kenyoshizoe/brio/brio_description/meshes/brio_l4.stl

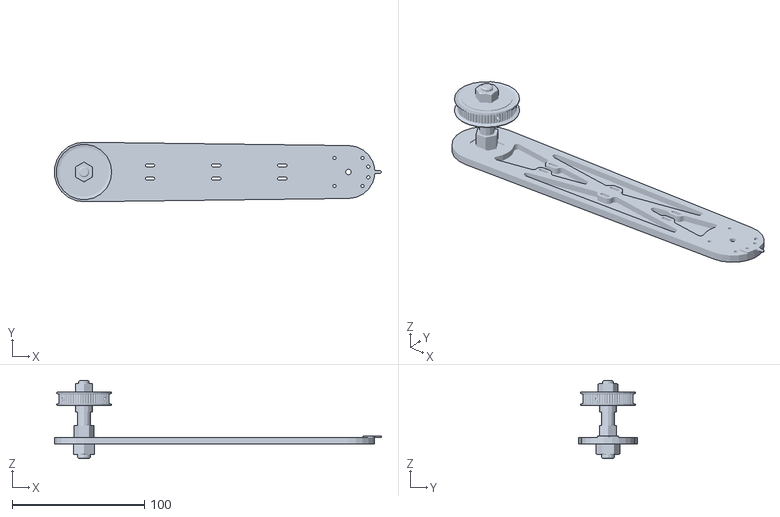
[picture p1: CAD file, 2023-04-27]
brio_description/meshes/brio_l4.stl
247.2 x 45.0 x 59.0
