kenyoshizoe/brio/brio_description/meshes/brio_l3.stl

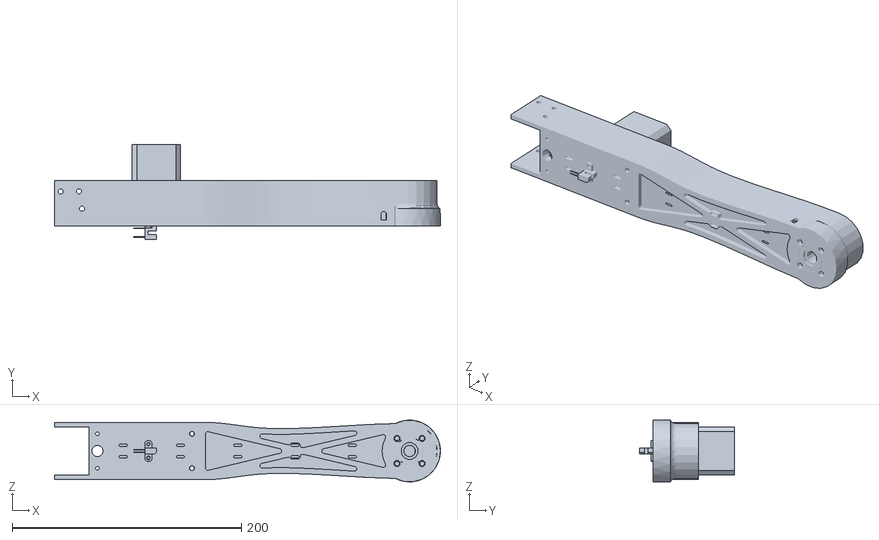
[picture p2: CAD file, 2023-04-27]
brio_description/meshes/brio_l3.stl
337.0 x 83.0 x 54.0
