kenyoshizoe/brio/brio_description/meshes/brio_l1.stl

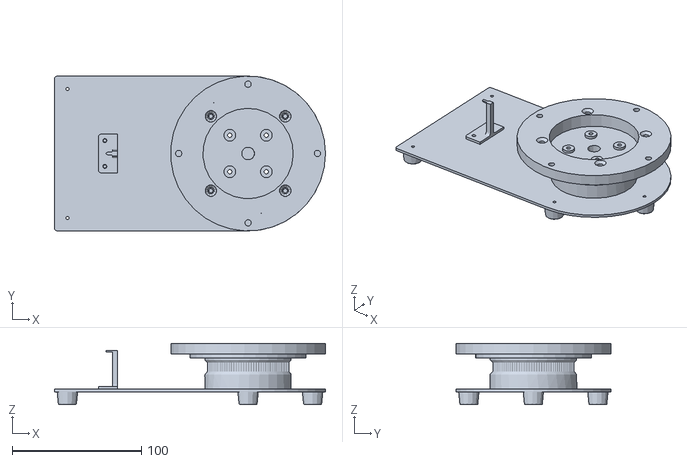
[picture p3: CAD file, 2023-04-27]
brio_description/meshes/brio_l1.stl
210.0 x 120.0 x 47.6
