kenyoshizoe/brio/brio_description/meshes/brio_l2.stl

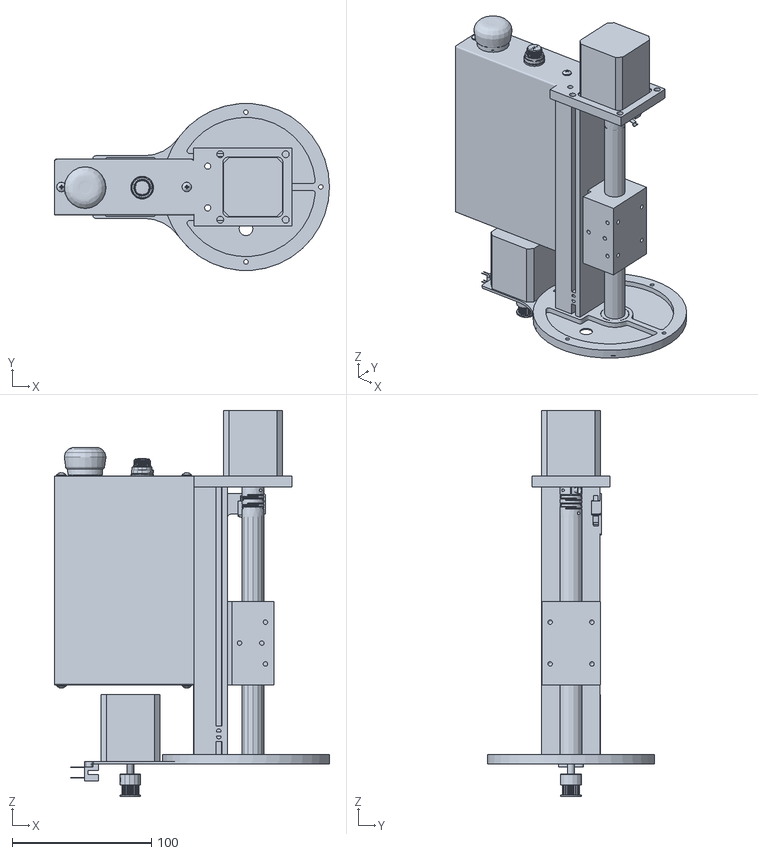
[picture p4: CAD file, 2023-04-27]
brio_description/meshes/brio_l2.stl
197.5 x 119.8 x 277.2
