kenyoshizoe/brio/(threads)

Thread 18 (2023-06-08):

手動操作用ノード作る

kenyoshizoe, 2023-06-08:
目標位置をコントローラで移動させてなんかのボタン押すと目標司令を送る、みたいな
目標位置はmarker出してrviz上で確認できるようにする

kenyoshizoe, 2023-06-08:
joystickの状態取得プログラム書くの面倒なので一旦
https://github.com/ros-drivers/joystick_drivers
でsensor_msgs/joy出してもらってそれを読んでどうこうする感じがいいかな
