kenyoshizoe/brio/pcb/main_board/main_board.kicad_pcb

## KiCad design pcb/main_board/main_board.kicad_pcb (2023-04-16)

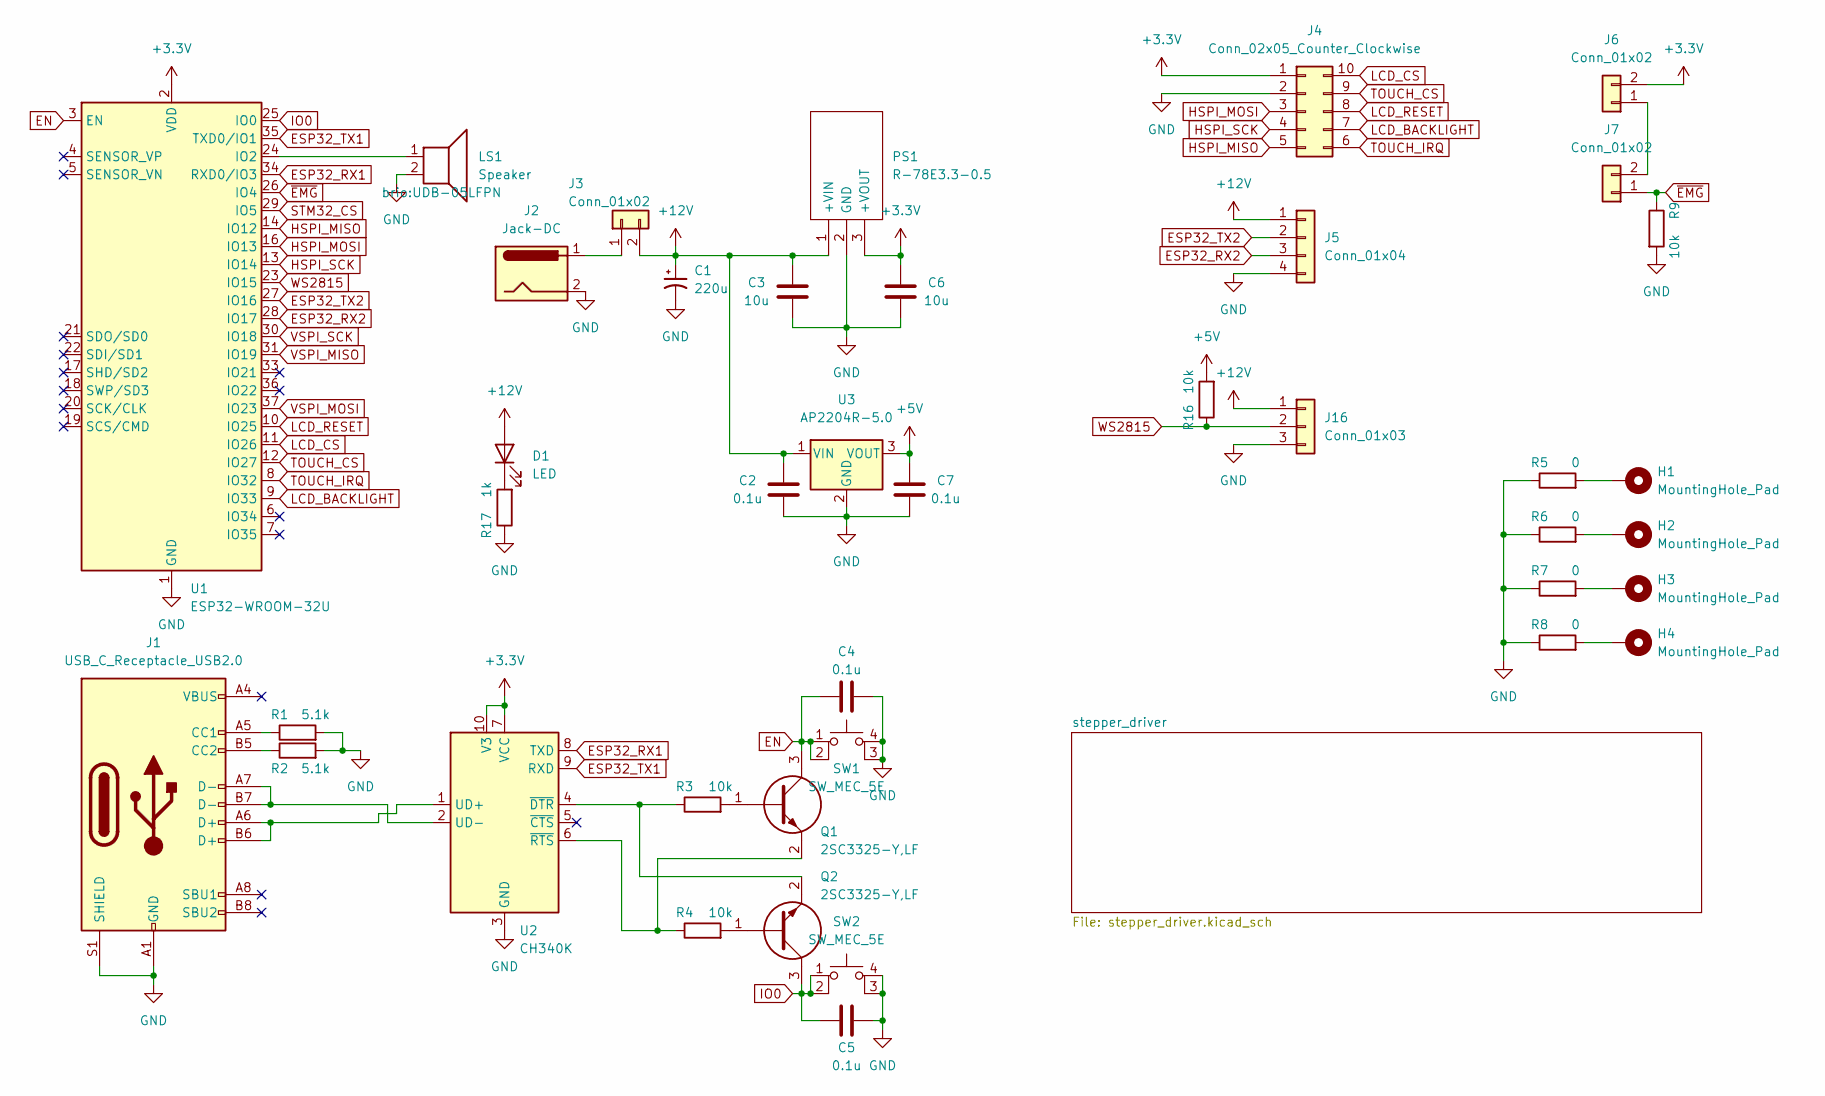
[picture p5: schematic main_board.kicad_sch]

Parts:
C1: 220u; CP_Elec_8x10
C2, C4, C5, C7: 0.1u; C_0603_1608Metric_Pad1.08x0.95mm_HandSolder
C3, C6: 10u; C_0603_1608Metric_Pad1.08x0.95mm_HandSolder
D1: LED; LED_0603_1608Metric_Pad1.05x0.95mm_HandSolder
H1, H2, H3, H4: MountingHole_Pad; MountingHole_3.2mm_M3_Pad_Via
J1: USB_C_Receptacle_USB2.0; USB_C_Receptacle_XKB_U262-16XN-4BVC11
J2: Jack-DC; 2DC-G213-D42
J3: Conn_01x02; JST_VH_B2P-VH_1x02_P3.96mm_Vertical
J4: Conn_02x05_Counter_Clockwise; PinHeader_2x05_P2.54mm_Vertical
J5: Conn_01x04; JST_PH_B4B-PH-K_1x04_P2.00mm_Vertical
J6: Conn_01x02; PinHeader_1x02_P2.54mm_Vertical
J7: Conn_01x02; PinHeader_1x02_P2.54mm_Horizontal
J16: Conn_01x03; JST_VH_B3P-VH_1x03_P3.96mm_Vertical
LS1: Speaker; UDB-05LFPN
PS1: R-78E3.3-0.5; R78E1205; Mouser Part Number 919-R-78E3.3-0.5
Q1, Q2: 2SC3325-Y,LF; 2SC3325YLF; Mouser Part Number 757-2SC3325-YLF
R1, R2: 5.1k; R_0603_1608Metric_Pad0.98x0.95mm_HandSolder
R3, R4, R9, R16: 10k; R_0603_1608Metric_Pad0.98x0.95mm_HandSolder
R5, R6, R7, R8: 0; R_0603_1608Metric_Pad0.98x0.95mm_HandSolder
R17: 1k; R_0603_1608Metric_Pad0.98x0.95mm_HandSolder
SW1, SW2: SW_MEC_5E; SKRPABE010
U1: ESP32-WROOM-32U
U2: CH340K; SSOP-10_3.9x4.9mm_P1.00mm
U3: AP2204R-5.0; SOT-89-3

Connections:
+3.3V: C6.2, J4.1, J6.2, PS1.3 (+VOUT), U1.2 (VDD), U2.7 (VCC), U2.10 (V3); also elsewhere on the board
+5V: C7.2, R16.2, U3.3 (VOUT)
+12V: C1.1, C2.2, C3.2, D1.2 (A), J3.2, J5.1, J16.1, PS1.1 (+VIN), U3.1 (VIN); also elsewhere on the board
EN: C4.2, Q1.3, SW1.1, SW1.2, U1.3 (EN)
ESP32_RX1: U1.34 (RXD0/IO3), U2.8 (TXD)
ESP32_RX2: J5.3, U1.28 (IO17)
ESP32_TX1: U1.35 (TXD0/IO1), U2.9 (RXD)
ESP32_TX2: J5.2, U1.27 (IO16)
GND: C1.2, C2.1, C3.1, C4.1, C5.1, C6.1, C7.1, J1.A1 (GND), J1.A12 (GND), J1.B1 (GND), J1.B12 (GND), J1.S1 (SHIELD), J2.2, J4.2, J5.4, J16.3, LS1.2, PS1.2 (GND), R1.2, R2.2, R5.1, R6.1, R7.1, R8.1, R9.2, R17.1, SW1.3 (K), SW1.4 (A), SW2.3 (K), SW2.4 (A), U1.1 (GND), U1.15 (GND), U1.38 (GND), U1.39 (GND), U2.3 (GND), U3.2 (GND); also elsewhere on the board
HSPI_MISO: J4.5, U1.14 (IO12)
HSPI_MOSI: J4.3, U1.16 (IO13)
HSPI_SCK: J4.4, U1.13 (IO14)
IO0: C5.2, Q2.3, SW2.1, SW2.2, U1.25 (IO0)
LCD_BACKLIGHT: J4.7, U1.9 (IO33)
LCD_CS: J4.10, U1.11 (IO26)
LCD_RESET: J4.8, U1.10 (IO25)
unnamed: D1.1 (K), R17.2
unnamed: H1.1, R5.2
unnamed: H2.1, R6.2
unnamed: H3.1, R7.2
unnamed: H4.1, R8.2
unnamed: J1.A5 (CC1), R1.1
unnamed: J1.A6 (D+), J1.B6 (D+), U2.1 (UD+)
unnamed: J1.A7 (D-), J1.B7 (D-), U2.2 (UD-)
unnamed: J1.B5 (CC2), R2.1
unnamed: J2.1, J3.1
unnamed: J6.1, J7.2
unnamed: LS1.1, U1.24 (IO2)
unnamed: Q1.1, R3.2
unnamed: Q1.2, R4.1, U2.6 (~RTS)
unnamed: Q2.1, R4.2
unnamed: Q2.2, R3.1, U2.4 (~DTR)
STM32_CS: U1.29 (IO5); also elsewhere on the board
TOUCH_CS: J4.9, U1.12 (IO27)
TOUCH_IRQ: J4.6, U1.8 (IO32)
VSPI_MISO: U1.31 (IO19); also elsewhere on the board
VSPI_MOSI: U1.37 (IO23); also elsewhere on the board
VSPI_SCK: U1.30 (IO18); also elsewhere on the board
WS2815: J16.2, R16.1, U1.23 (IO15)
~EMG: J7.1, R9.1, U1.26 (IO4); also elsewhere on the board

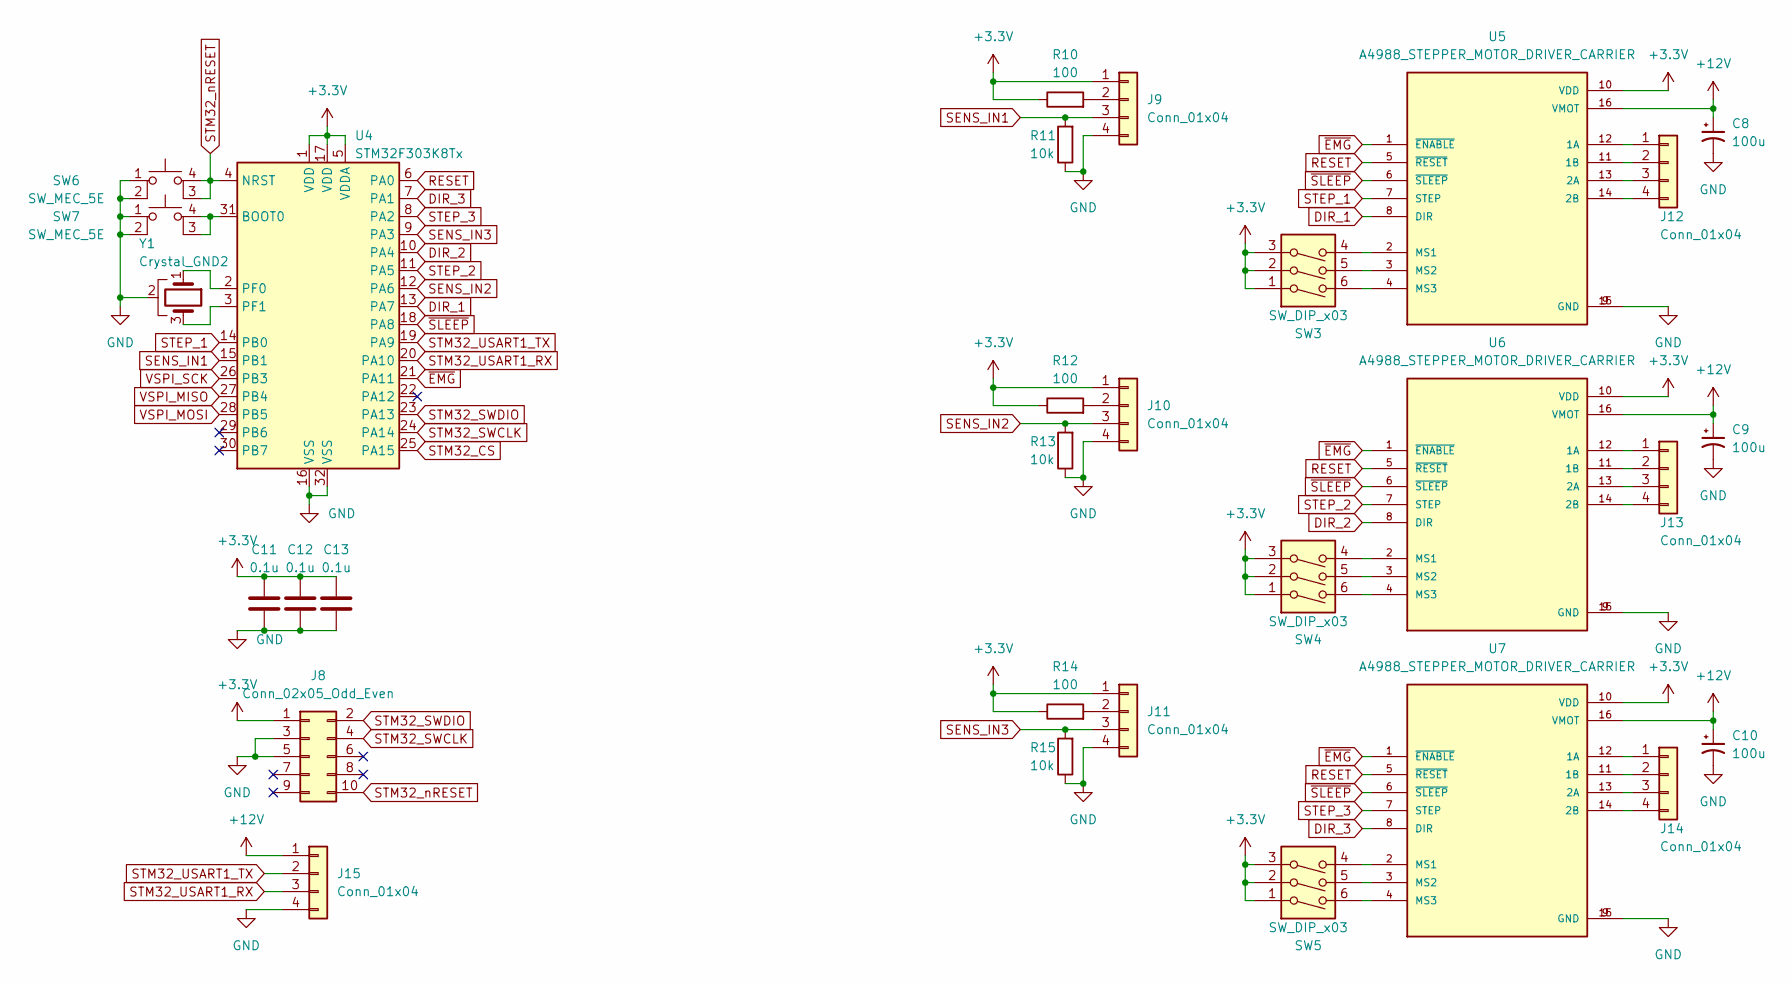
[picture p6: schematic stepper_driver.kicad_sch]

Parts:
C8, C9, C10: 100u; CP_Elec_6.3x5.7
C11, C12, C13: 0.1u; C_0603_1608Metric_Pad1.08x0.95mm_HandSolder
J8: Conn_02x05_Odd_Even; PinHeader_2x05_P1.27mm_Vertical
J9, J10, J11: Conn_01x04; JST_XH_B4B-XH-A_1x04_P2.50mm_Vertical
J12, J13, J14: Conn_01x04; JST_VH_B4P-VH_1x04_P3.96mm_Vertical
J15: Conn_01x04; JST_PH_B4B-PH-K_1x04_P2.00mm_Vertical
R10, R12, R14: 100; R_0603_1608Metric_Pad0.98x0.95mm_HandSolder
R11, R13, R15: 10k; R_0603_1608Metric_Pad0.98x0.95mm_HandSolder
SW3, SW4, SW5: SW_DIP_x03; SW_DIP_SPSTx03_Slide_6.7x9.18mm_W7.62mm_P2.54mm_LowProfile
SW6, SW7: SW_MEC_5E; SKRPABE010
U4: STM32F303K8Tx; LQFP-32_7x7mm_P0.8mm
U5, U6, U7: A4988_STEPPER_MOTOR_DRIVER_CARRIER; MODULE_A4988_STEPPER_MOTOR_DRIVER_CARRIER
Y1: Crystal_GND2; Resonator_SMD_Murata_CSTxExxV-3Pin_3.0x1.1mm_HandSoldering

Connections:
+3.3V: C11.2, C12.2, C13.2, J8.1, J9.1, J10.1, J11.1, R10.1, R12.1, R14.1, SW3.1, SW3.2, SW3.3, SW4.1, SW4.2, SW4.3, SW5.1, SW5.2, SW5.3, U4.1 (VDD), U4.5 (VDDA), U4.17 (VDD), U5.10 (VDD), U6.10 (VDD), U7.10 (VDD); also elsewhere on the board
+12V: C8.1, C9.1, C10.1, J15.1, U5.16 (VMOT), U6.16 (VMOT), U7.16 (VMOT); also elsewhere on the board
DIR_1: U4.13 (PA7), U5.8 (DIR)
DIR_2: U4.10 (PA4), U6.8 (DIR)
DIR_3: U4.7 (PA1), U7.8 (DIR)
GND: C8.2, C9.2, C10.2, C11.1, C12.1, C13.1, J8.3, J8.5, J9.4, J10.4, J11.4, J15.4, R11.1, R13.1, R15.1, SW6.1, SW6.2, SW7.1, SW7.2, U4.16 (VSS), U4.32 (VSS), U5.9 (GND), U5.15 (GND), U6.9 (GND), U6.15 (GND), U7.9 (GND), U7.15 (GND), Y1.2; also elsewhere on the board
unnamed: J9.2, R10.2
unnamed: J10.2, R12.2
unnamed: J11.2, R14.2
unnamed: J12.1, U5.12 (1A)
unnamed: J12.2, U5.11 (1B)
unnamed: J12.3, U5.13 (2A)
unnamed: J12.4, U5.14 (2B)
unnamed: J13.1, U6.12 (1A)
unnamed: J13.2, U6.11 (1B)
unnamed: J13.3, U6.13 (2A)
unnamed: J13.4, U6.14 (2B)
unnamed: J14.1, U7.12 (1A)
unnamed: J14.2, U7.11 (1B)
unnamed: J14.3, U7.13 (2A)
unnamed: J14.4, U7.14 (2B)
unnamed: SW3.4, U5.2 (MS1)
unnamed: SW3.5, U5.3 (MS2)
unnamed: SW3.6, U5.4 (MS3)
unnamed: SW4.4, U6.2 (MS1)
unnamed: SW4.5, U6.3 (MS2)
unnamed: SW4.6, U6.4 (MS3)
unnamed: SW5.4, U7.2 (MS1)
unnamed: SW5.5, U7.3 (MS2)
unnamed: SW5.6, U7.4 (MS3)
unnamed: SW7.3 (K), SW7.4 (A), U4.31 (BOOT0)
unnamed: U4.2 (PF0), Y1.1
unnamed: U4.3 (PF1), Y1.3
RESET: U4.6 (PA0), U5.5 (~RESET), U6.5 (~RESET), U7.5 (~RESET)
SENS_IN1: J9.3, R11.2, U4.15 (PB1)
SENS_IN2: J10.3, R13.2, U4.12 (PA6)
SENS_IN3: J11.3, R15.2, U4.9 (PA3)
STEP_1: U4.14 (PB0), U5.7 (STEP)
STEP_2: U4.11 (PA5), U6.7 (STEP)
STEP_3: U4.8 (PA2), U7.7 (STEP)
STM32_CS: U4.25 (PA15); also elsewhere on the board
STM32_SWCLK: J8.4, U4.24 (PA14)
STM32_SWDIO: J8.2, U4.23 (PA13)
STM32_USART1_RX: J15.3, U4.20 (PA10)
STM32_USART1_TX: J15.2, U4.19 (PA9)
STM32_nRESET: J8.10, SW6.3 (K), SW6.4 (A), U4.4 (NRST)
VSPI_MISO: U4.27 (PB4); also elsewhere on the board
VSPI_MOSI: U4.28 (PB5); also elsewhere on the board
VSPI_SCK: U4.26 (PB3); also elsewhere on the board
~EMG: U4.21 (PA11), U5.1 (~ENABLE), U6.1 (~ENABLE), U7.1 (~ENABLE); also elsewhere on the board
~SLEEP: U4.18 (PA8), U5.6 (~SLEEP), U6.6 (~SLEEP), U7.6 (~SLEEP)

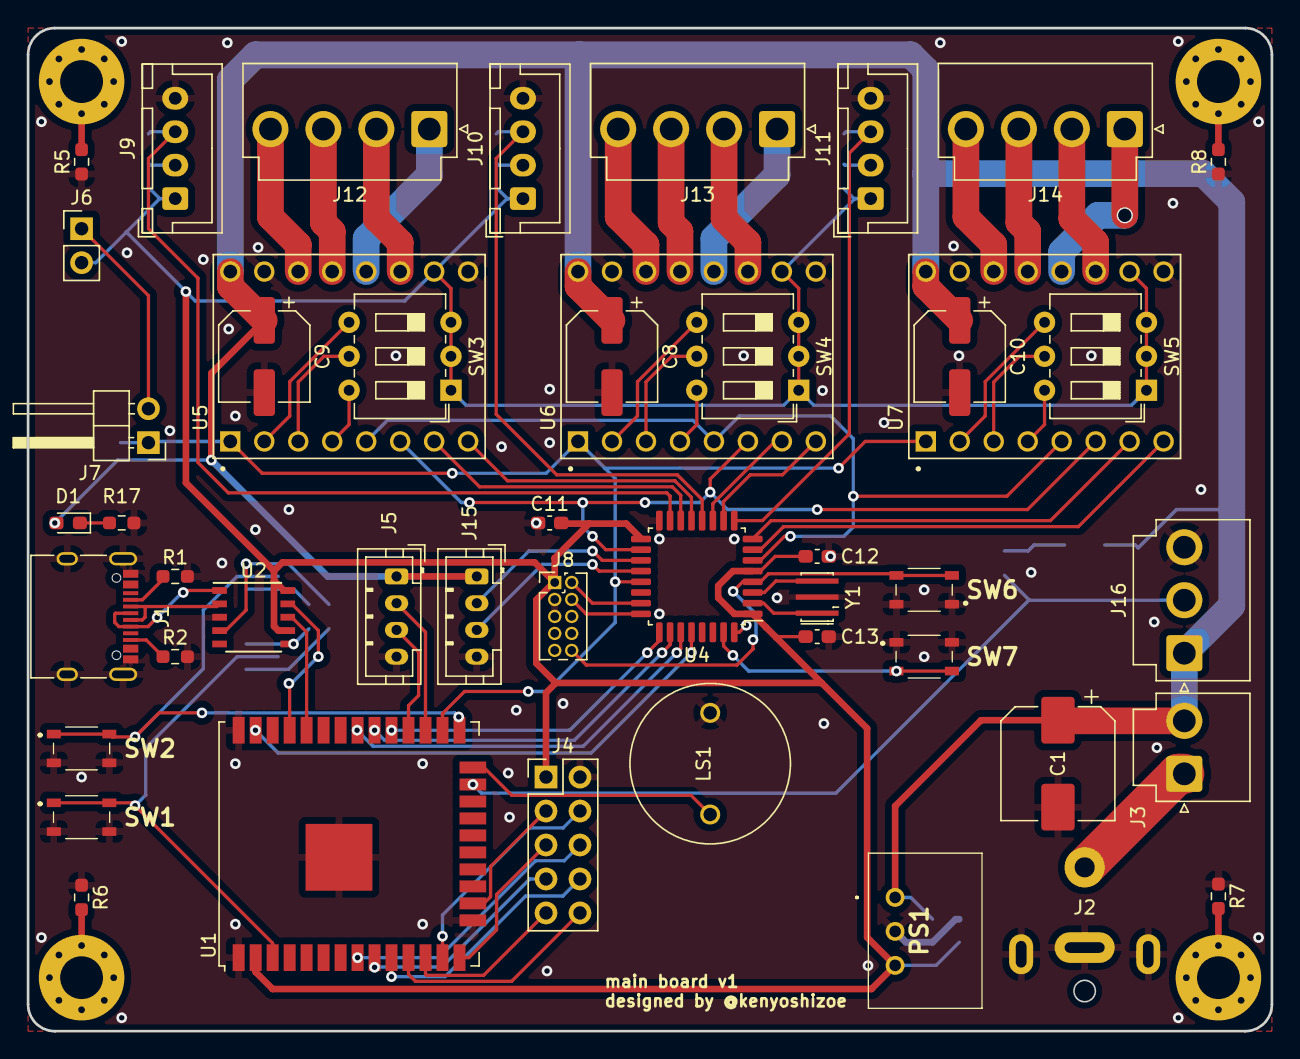
[picture p7: board main_board.kicad_pcb from above]

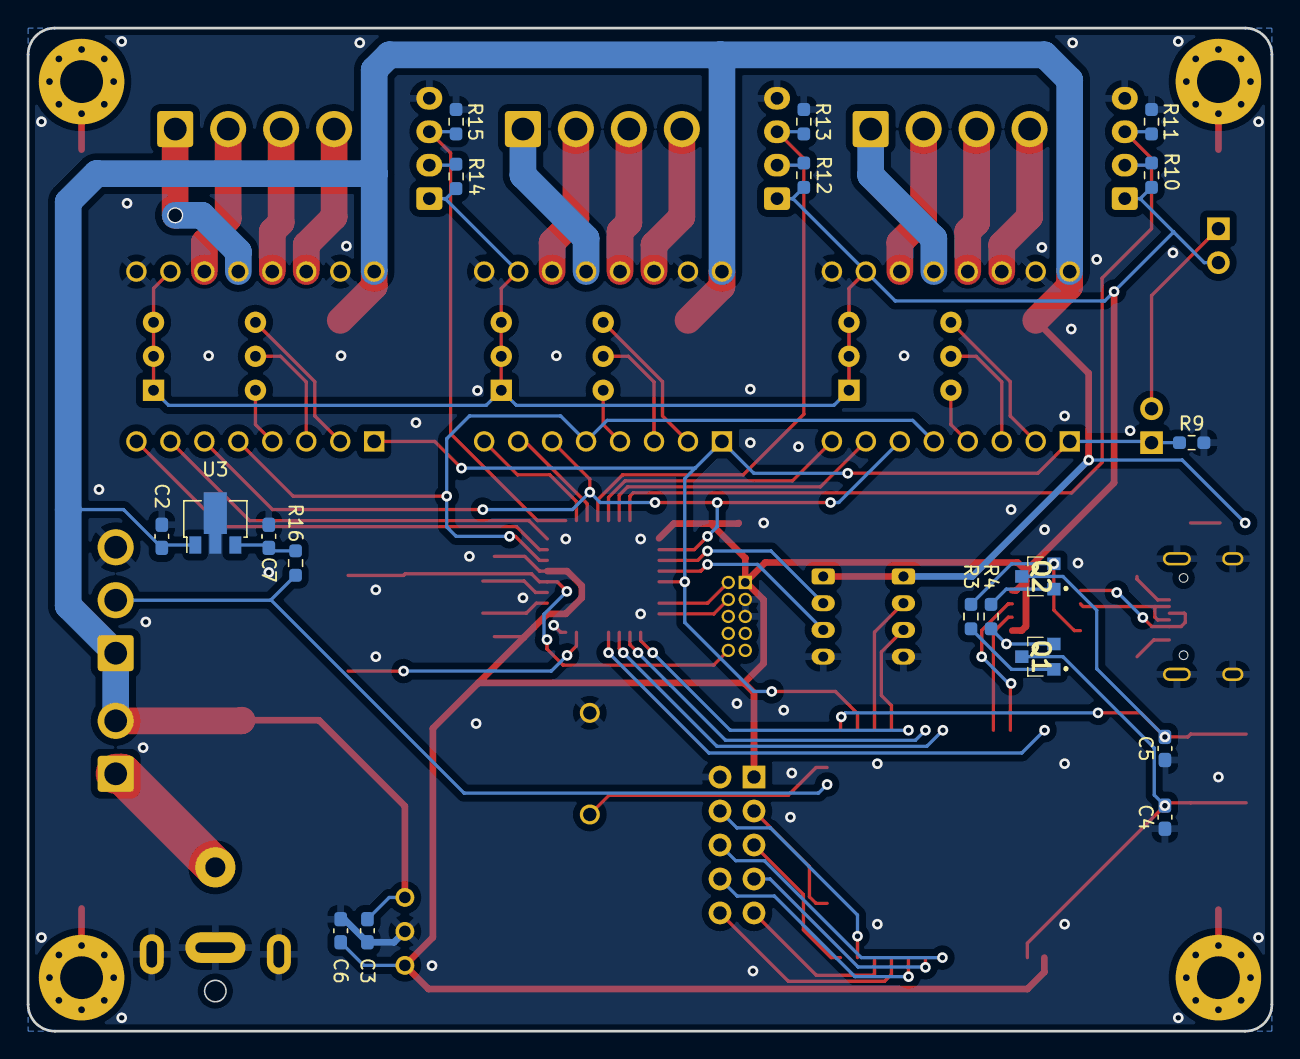
[picture p8: board main_board.kicad_pcb from below]

Board: 2 copper layers, 93.0 x 75.0 mm, 70 parts (19 on the bottom side), 83 nets.
