kenyoshizoe/brio/firmware/brio_stepper_driver/brio_stepper_driver.ioc

Mcu.UserName=STM32F303K8Tx
PA0.GPIO_Label=STEPPER_RESET
PA0.Signal=GPIO_Output
PA1.GPIO_Label=STEPPER3_DIR
PA1.Signal=GPIO_Output
PA10.Signal=USART1_RX
PA11.GPIO_Label=STEPPER_EMG
PA11.Signal=GPIO_Input
PA13.Signal=SYS_JTMS-SWDIO
PA14.Signal=SYS_JTCK-SWCLK
PA15.Signal=SPI1_NSS
PA2.GPIO_Label=STEPPER3_STEP
PA2.Signal=S_TIM15_CH1
PA3.GPIO_Label=STEPPER3_SENS
PA3.Signal=GPIO_Input
PA4.GPIO_Label=STEPPER2_DIR
PA4.Signal=GPIO_Output
PA5.GPIO_Label=STEPPER2_STEP
PA5.Signal=S_TIM2_CH1_ETR
PA6.GPIO_Label=STEPPER2_SENS
PA6.Signal=GPIO_Input
PA7.GPIO_Label=STEPPER1_DIR
PA7.Signal=GPIO_Output
PA8.GPIO_Label=STEPPER_SLEEP
PA8.Signal=GPIO_Output
PA9.Signal=USART1_TX
PB0.GPIO_Label=STEPPER1_STEP
PB0.Signal=S_TIM3_CH3
PB1.GPIO_Label=STEPPER1_SENS
PB1.Signal=GPIO_Input
PB3.Signal=SPI1_SCK
PB4.Signal=SPI1_MISO
PB5.Signal=SPI1_MOSI
