kenyoshizoe/brio/firmware/brio_stepper_driver/Core/Inc/main.h

#define STEPPER_RESET_Pin GPIO_PIN_0
#define STEPPER_RESET_GPIO_Port GPIOA
#define STEPPER3_DIR_Pin GPIO_PIN_1
#define STEPPER3_DIR_GPIO_Port GPIOA
#define STEPPER3_STEP_Pin GPIO_PIN_2
#define STEPPER3_STEP_GPIO_Port GPIOA
#define STEPPER3_SENS_Pin GPIO_PIN_3
#define STEPPER3_SENS_GPIO_Port GPIOA
#define STEPPER2_DIR_Pin GPIO_PIN_4
#define STEPPER2_DIR_GPIO_Port GPIOA
#define STEPPER2_STEP_Pin GPIO_PIN_5
#define STEPPER2_STEP_GPIO_Port GPIOA
#define STEPPER2_SENS_Pin GPIO_PIN_6
#define STEPPER2_SENS_GPIO_Port GPIOA
#define STEPPER1_DIR_Pin GPIO_PIN_7
#define STEPPER1_DIR_GPIO_Port GPIOA
#define STEPPER1_STEP_Pin GPIO_PIN_0
#define STEPPER1_STEP_GPIO_Port GPIOB
#define STEPPER1_SENS_Pin GPIO_PIN_1
#define STEPPER1_SENS_GPIO_Port GPIOB
#define STEPPER_SLEEP_Pin GPIO_PIN_8
#define STEPPER_SLEEP_GPIO_Port GPIOA
#define STEPPER_EMG_Pin GPIO_PIN_11
#define STEPPER_EMG_GPIO_Port GPIOA
