kenyoshizoe/brio/(commit log)

2023-04-09 :tada: generate project
    [main_board.kicad_pcb, main_board.kicad_sch]
2023-04-16 🎉 add main_board pcb
    [main_board.kicad_pcb, main_board.kicad_sch, stepper_driver.kicad_sch]
2023-04-16 🎉 generate project
2023-04-16 🐛 fix a4988 lib
2023-04-16 🐛 minor fix
    [main_board.kicad_pcb, main_board.kicad_sch]
2023-04-19 ✨ add pin_assign
2023-04-19 ✨ add init buzzer
2023-04-23 ✨ set pin user label
2023-04-23 ➕ add SEGGER-RTT as submodule
2023-04-23 🔧 add build in .gitsubmodule
2023-04-23 🔧 configure .vscode
2023-04-23 ✨ change pin setting adc -> gpio input
2023-04-23 ✨ enable tim
2023-04-23 ✨ configure makefile for cpp
2023-04-23 🐛 fix makefile
2023-04-24 ✨ configure pwm settings
2023-04-24 ✨ configure tim settings
2023-04-24 🎉 add a4988 class
2023-04-24 🎉 add app.h/cc
2023-04-24 ➕ c++17
2023-04-24 ♻️ refuctor
2023-04-24 ✨ change app
2023-04-24 🐛 fix boundary process
    [a4988.cc, app.cc]
2023-04-25 :bug: fix set accel unit
    [a4988.h]
2023-04-25 ➕ add etl as submodule
2023-04-25 ✨ add etl include in makefile
2023-04-25 🐛 fix speed set
    [a4988.cc, a4988.h]
2023-04-27 :tada: add brio_description
    [brio.urdf.xacro, brio_l1.stl, brio_l2.stl, brio_l3.stl, brio_l4.stl]
2023-04-27 🎉 enable iwdg
2023-04-27 :sparkles: add buzzer class
    [main.cc]
2023-04-28 :sparkles: change cubemx spi settting
2023-04-28 :tada: add stepper driver receive cmd process
2023-04-28 :tada: add StepperDriver class to main
2023-04-28 :sparkles: add timer callback communication with stepper_driver
2023-04-29 :bug: fix stepper driver class
2023-06-08 :tada: add process to communicate with pc via uart
2023-06-08 :sparkles: add thread finish process
2023-06-08 :bug: fix position / velocity coord
