kenyoshizoe/brio/(notices)

Notices in the files:
firmware/brio_stepper_driver/Core/Inc/main.h:
Copyright (c) 2023 STMicroelectronics.
All rights reserved.
This software is licensed under terms that can be found in the LICENSE file
